nigeyuk/Microchu/MicroChu-328-V2-Final.brd

## EAGLE design MicroChu-328-V2-Final.brd (2013-02-26)

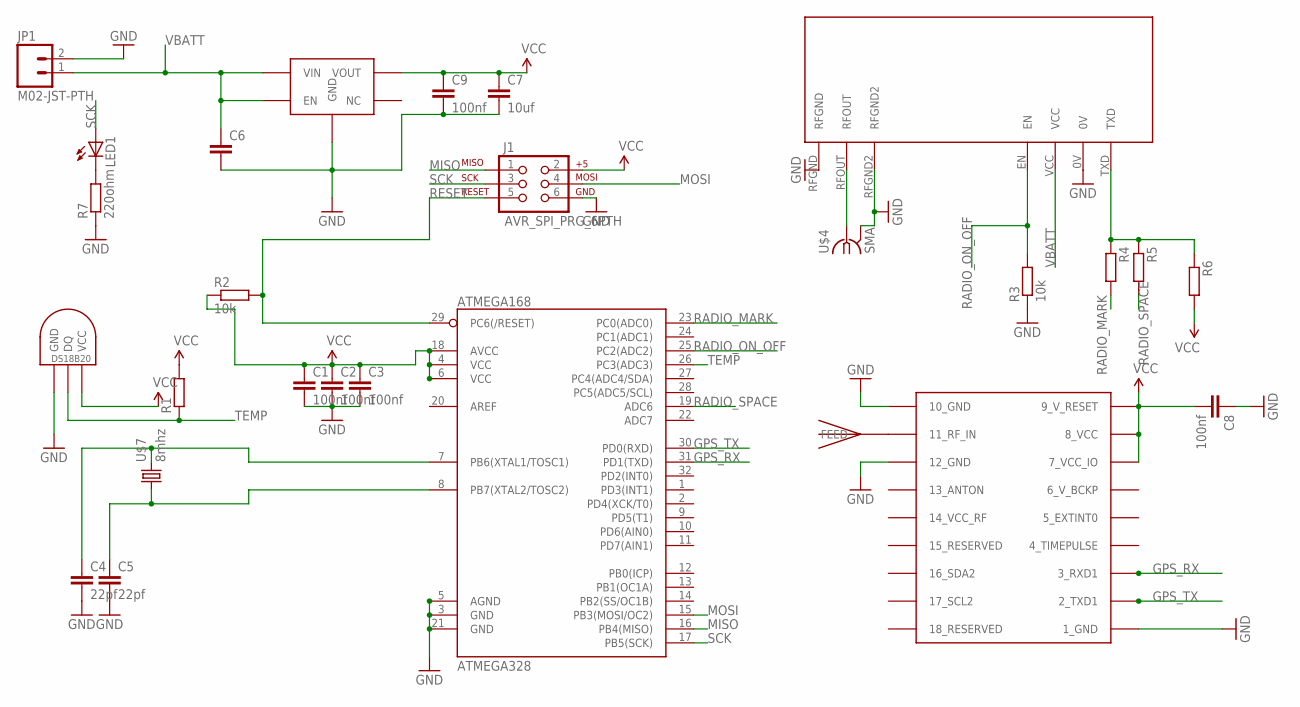
[picture p1: schematic MicroChu-328-V2-Final.sch]

Parts:
3V3: ADP122AUJZ-3V3REG-5TSOT; SOT23-5L
ATMEGA328: ATMEGA168; TQFP32-08
C1, C2, C3, C8, C9: 100nf; C0805
C4, C5: 22pf; C0805
C6: C-EUC0805; C0805
C7: 10uf; C0805
J1: AVR_SPI_PRG_6PTH; 2X3
JP1: M02-JST-PTH
LED1: LED1206; LED-1206
R1, R4, R5, R6: R-EU_R0805; R0805
R2, R3: 10k; R0805
R7: 220ohm; R0805
U$1: JTI_ANTENNA-1575AT43A40
U$2: NTX2
U$3: UBLOX_MAX-6
U$4: SMA; BU-SMA-H
U$6: DS1820TO92; DS1820
U$7: 8mhz; ABRACON_ABM3_CRYSTAL

Connections:
GND: 3V3.2 (GND), ATMEGA328.3 (GND), ATMEGA328.5 (AGND), ATMEGA328.21 (GND), C1.2, C2.2, C3.2, C4.2, C5.2, C6.2, C7.2, C8.1, C9.2, J1.6, JP1.2, R3.1, R7.1, U$2.0V, U$2.RFGND, U$2.RFGND2, U$3.1_GND, U$3.10_GND, U$3.12_GND, U$4.2 (GND), U$4.3 (GND), U$4.4 (GND), U$4.5 (GND), U$6.GND
GPS_RX: ATMEGA328.31 (PD1(TXD)), U$3.3_RXD1
GPS_TX: ATMEGA328.30 (PD0(RXD)), U$3.2_TXD1
MISO: ATMEGA328.16 (PB4(MISO)), J1.1
MOSI: ATMEGA328.15 (PB3(MOSI/OC2)), J1.4
unnamed: ATMEGA328.7 (PB6(XTAL1/TOSC1)), C4.1, U$7.P$2 (2)
unnamed: LED1.C, R7.2
unnamed: ATMEGA328.8 (PB7(XTAL2/TOSC2)), C5.1, U$7.P$1 (1)
unnamed: U$1.FEED, U$3.11_RF_IN
unnamed: R4.1, R5.1, R6.1, U$2.TXD
unnamed: U$2.RFOUT, U$4.1
RADIO_MARK: ATMEGA328.23 (PC0(ADC0)), R4.2
RADIO_ON_OFF: ATMEGA328.25 (PC2(ADC2)), R3.2, U$2.EN
RADIO_SPACE: ATMEGA328.19 (ADC6), R5.2
RESET: ATMEGA328.29 (PC6(/RESET)), J1.5, R2.2
SCK: ATMEGA328.17 (PB5(SCK)), J1.3, LED1.A
TEMP: ATMEGA328.26 (PC3(ADC3)), R1.1, U$6.DQ
VBATT: 3V3.1 (VIN), 3V3.3 (EN), C6.1, JP1.1, U$2.VCC
VCC: 3V3.5 (VOUT), ATMEGA328.4 (VCC), ATMEGA328.6 (VCC), ATMEGA328.18 (AVCC), C1.1, C2.1, C3.1, C7.1, C8.2, C9.1, J1.2, R1.2, R2.1, R6.2, U$3.7_VCC_IO, U$3.8_VCC, U$3.9_V_RESET, U$6.VDD (VCC)

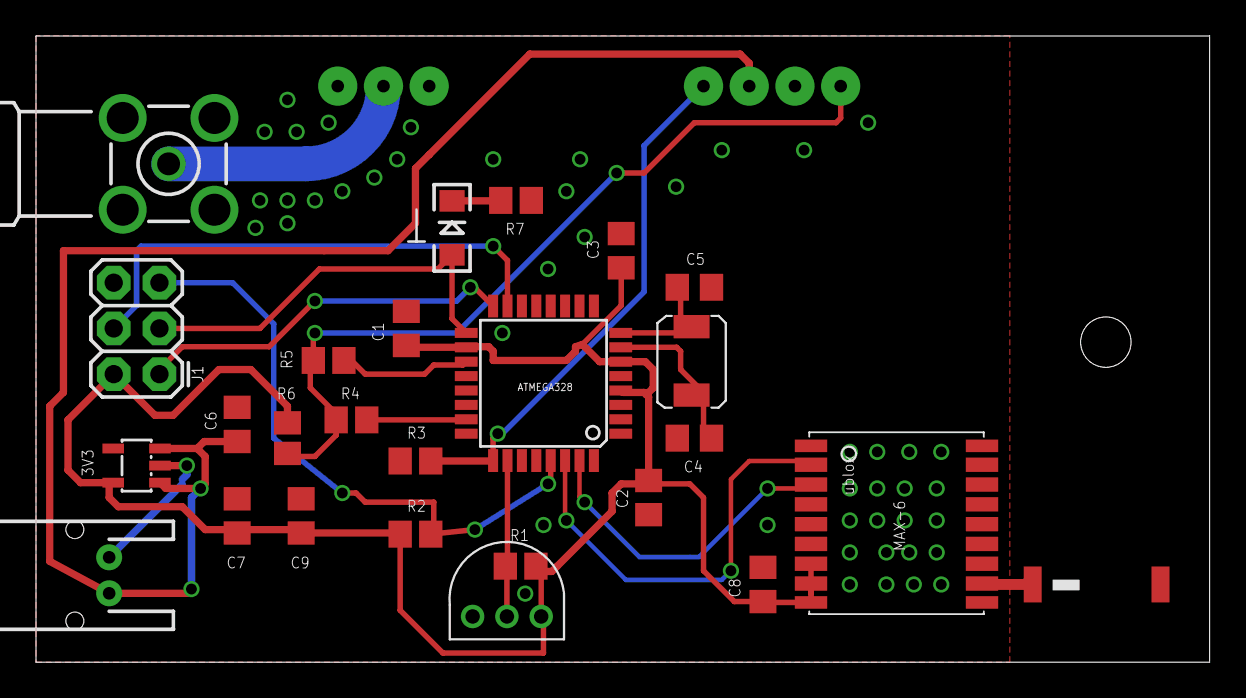
[picture p2: board MicroChu-328-V2-Final.brd from above]

Board: 2 copper layers, 65.2 x 34.8 mm, 27 parts (1 on the bottom side), 19 nets.
