nigeyuk/Microchu/(commit log)

2013-02-24 Fixed incorrect crccat value causing checksums to fail
    [microchu.c]
2013-02-26 included schematics and board files
    [MicroChu-328-V2-Final.brd, MicroChu-328-V2-Final.sch]
2013-03-08 First attempts at powersaving
2013-03-10 More powersaving features, thanks Phil!
2013-03-11 changed location of psm, fixes psm read errors
    [microchu.c]
